Henriquess19/LIC_2021/Módulos/ModuloDoorController_G5.docx

O módulo Door Controller é constituído por 3 blocos, sendo dois desses hardware e um dos componentes software. A primeira componente baseia-se num controlador em software, a segunda é um controlador em hardware da porta e a última componente é a porta em questão.

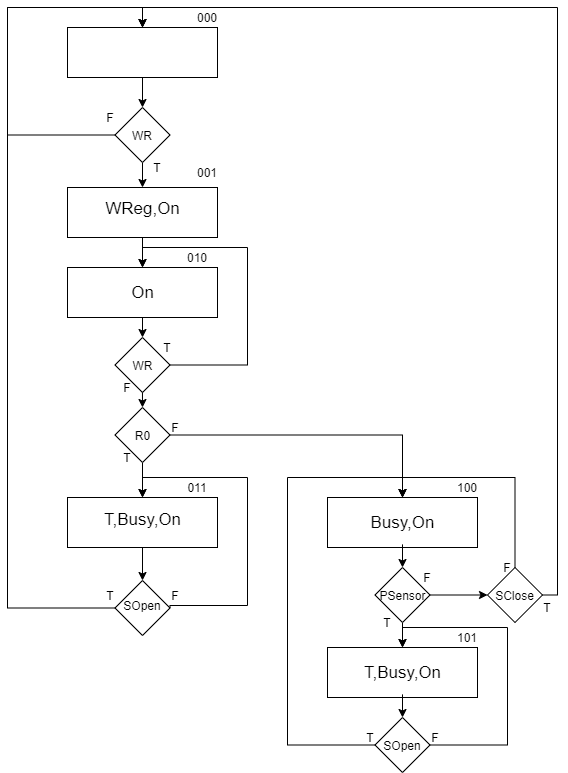
[picture p30: figure]

Figura 1 – Diagrama de blocos do módulo Door Controller

# 1 Controller

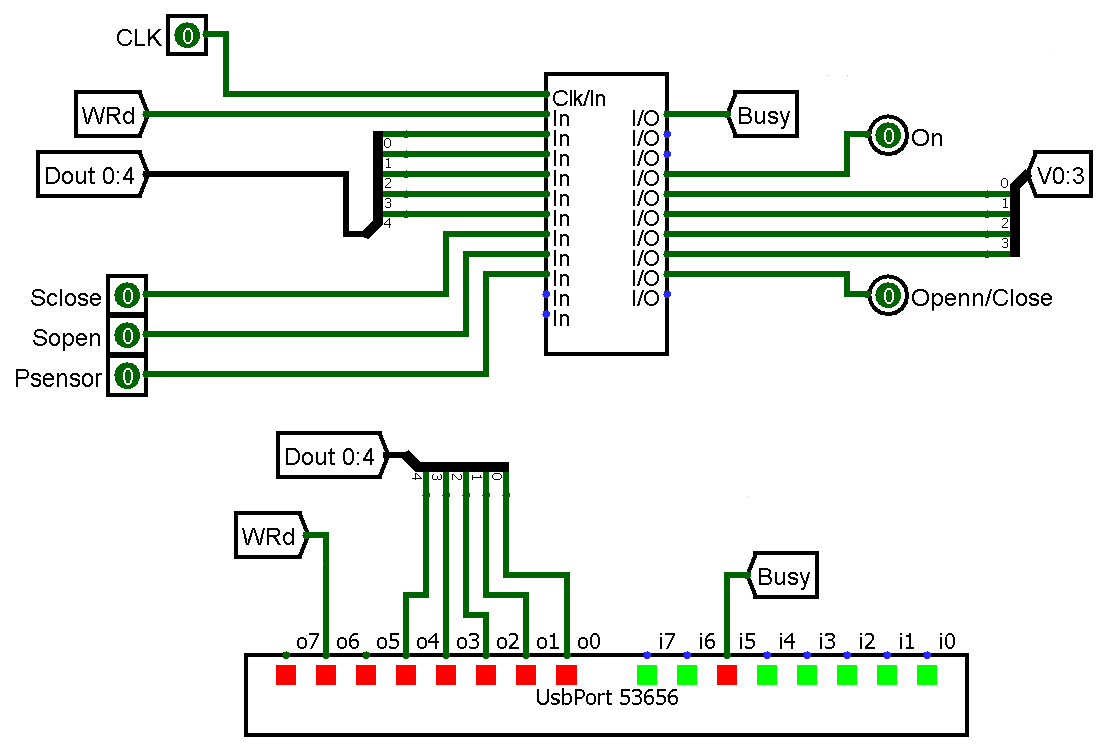
[picture p31: figure]

O bloco Controller implementa uma máquina de estados, que pode ser observada na figura 2 e a sua implementação em logisim e o seu ASM-chart na figura 3. É possível com esta implementação de hardware realizar uma ponte entre o software ao dispositivo da porta, tendo assim acesso e controlo do manuseamento da mesma. É possível enviar um simples comando e obter o processamento completo através de uma máquina de estados, e assim ter uma porta em funcionamento, com simples comando do hardware só. É demonstrada a implementação da pal com as conexões de entrada e saídas da mesma, na figura seguinte.

Figura 2 – Implementação Logisim do Controller

O bloco Controller foi implementado pela máquina de estados representada em ASM-chart na figura 3. Tendo como estado inicial o repouso, é permitida o avanço para estado seguinte conforme a indicação que existe uma leitura de dados a ser feita vinda do Control (WR), após passagem para o primeiro estado, onde se liga a máquina e colocação do valor do WReg a ‘1’ para registo dos valores de provenientes do Control. O estado seguinte serve para garantir que o sinal de clock do register se desloca para ‘0’ e que depois é verificado consoante o bit de maior peso da variável registada se era realizada a instrução de abertura ou fecho da porta, sendo a variável T a indicação que a operação é de abertura, no caso se for de abertura a porta só tem de se preocupar com o término da ação da mesma, se for de fecho tem de ter em preocupação adicional a verificação até à conclusão do seu fecho da existência da aparição de alguma pessoa, se tal deve de executar o método de abertura e depois pode realizar de novo o seu método de fecho ( pode ser observado no estado 4 e 5).

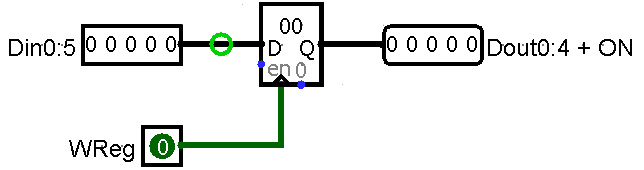
[picture p32: figure]

Figura 3– Máquina de estados do bloco Controller

Figura 4– Register da velocidade e acção da porta fornecidos pelo Control

A descrição hardware do bloco Controller em CUPL encontra-se no Anexo A.

Com base nas descrições do bloco Controller implementou-se parcialmente o módulo Door Controller de acordo com o esquema elétrico representado no Anexo B. Os clocks dados pela máquina são equivalentes ao clocks do modulo do Key Decode, 1KHz, permitindo assim que o projeto num todo trabalhe com união e todos poderem usufruir da mesma frequência de trabalho, excetuados os módulos que necessitam de uma menor por observações realizadas nos mesmos.

Em relação à latência de entrada no hardware, é muito baixa devido a ser providenciada por parte do software o que proporciona tempos de resposta mais pequenos, aquando comparados com os que são obtidos através dos mecanismos físicos. Em relação à latência de processamento e de saída da mesma, são valores maiores que os obtidos através do software, mas podem ser considerados "desprezáveis”, pois não afetam o funcionamento de um todo.

# 2 Interface com o Control

Implementou-se o módulo Control em software, recorrendo a linguagem Kotlin e seguindo a arquitetura lógica apresentada na Figura 5.

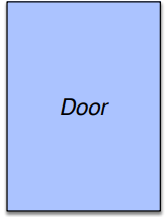
[picture p33: figure]
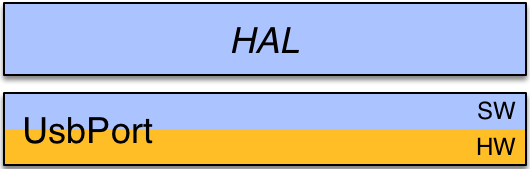
[picture p34: figure]

Figura 5 – Diagrama lógico do módulo Control de interface com o módulo Door Controller

A classe Door desenvolvida é descrita na secção 2.1., e o código fonte desenvolvido no Anexo C.

## 2.1 Classe Door

A classe Door foi implementada em 3 funções, excluindo a função de inicialização da mesma. A mesma, a função de inicialização baseia-se em colocar o WR a bit lógico ‘0’ para o sistema saber que se encontra no primeiro estado da máquina e assim só avançar do mesmo quando a chamada de alguma das funções quer de abertura ou de fecho.

Quer a função de abertura e de fecho, possuem um parâmetro que é a velocidade (speed), sendo a mesma que vai determinar a velocidade com que a porta executa a sua ação, esta devido a ser representada no máximo com 4 bits, o valor máximo que pode ser alcançado é de 15. O código em software não verifica a utilização da existência de pessoas ou se já se encontra aberta ou fechada, o único parâmetro a que tem acesso é o de ocupado (busy), o que permite o sistema saber se a ação foi concluída ou não.

Ambas as funções funcionam então de um método geral, semelhantes, verificando primeiro se a velocidade imposta não ultrapassa o máximo de 15. Depois caso a porta ainda esteja a processar um comando antigo, a função fica a espera que o bit de busy tenha o valor logico’0’, para executar o resto da função. Depois de ter a certeza que pode executar, escreve o valor da máscara de saída baseado na velocidade mais a indicação de se vai ser aberta ou fechada, que provêm da adição de 0x10, pois ao ser usado como o maior bit do inteiro que é aplicado ao HAL, permite que o mesmo não altere a velocidade desejada. Ambas as operações são concluídas quando há indicação que a porta já não se encontra mais ocupada; esta ação pode ser com a utilização da última função implementada onde a mesma indica se houve término conforme o valor do bit lógico de busy.

# 3 Conclusões

O módulo do Door Controller, é implementado com as suas duas vertentes necessárias para tal realização, a sua componente de software e a de hardware que permitem, em conjunto, que a porta consiga ter e realizar os devidos propósitos. Com a componente software é possível ter-se por parte de todo o sistema o conhecimento se a porta se encontra em uso ou não, o que acaba por ser prático e vantajoso; software também permite mudar a velocidade em questão o que ajuda a mudar conforme as situações que forem impostas e não só neste caso específico.

Tudo isto é possível por intermediário do bloco de hardware, que através da sua implementação com a atribuição da máquina de estados permite ao sistema gerir quer as informações transmitidas pelo software quer as informações que vão sendo transmitidas pela porta e realizar o melhor com as mesmas, quer abrir durante o fecho, em caso da presença de pessoa, quer nos casos mais simples e normais só de abertura e fecho sem interrupções da mesma.

# A. Descrição CUPL do bloco Controller


# B. Esquema elétrico do módulo Door Controller


# C. Código Kotlin da classe Door

object Door{
private const val WR_MASK = 0x40
private const val BUSY_MASK = 0x20
private const val D_OUT_MASK = 0x1F
private const val MAX_SPEED = 0x0F

private const val OPEN_CMD = 0x10
private const val CLOSE_CMD = 0x00

fun init(){
HAL.clrBits(WR_MASK)
}

/**
* V0~3 -> 0x0F
*
* OpenClose -> OPEN = 0x10 & CLOSE = 0x00
*/

fun open(speed:Int){
var spd = speed
if (spd > MAX_SPEED) spd = MAX_SPEED
val x = OPEN_CMD + spd /*Open action + speed*/
while (HAL.isBit(BUSY_MASK)){} /*Waiting for the busy signal*/
HAL.writeBits(D_OUT_MASK, x)
HAL.setBits(WR_MASK)
HAL.clrBits(WR_MASK)

}

fun close(speed: Int){
var spd=speed
if (spd > MAX_SPEED) spd=MAX_SPEED
val x = CLOSE_CMD + spd /*Close action + speed*/
while (HAL.isBit(BUSY_MASK)){} /*Waiting for the busy signal*/
HAL.writeBits(D_OUT_MASK,x)
HAL.setBits(WR_MASK)
HAL.clrBits(WR_MASK)
}


fun isFinished():Boolean{
return !HAL.isBit(BUSY_MASK)
}
}

fun main(){

Door.init()

while (true) {

val x = (-100..100).random() /* TestCode to give random number so door open or close with the value of x*/

println(x)

if (x <= 0) {

Door.close(12)

} else {

Door.open(12)

}

while (!Door.isFinished()){}

}

}

Door Controller (Working Time Recorder) Laboratório de Informática e Computadores 2020 / 2021 verão Autores: Ricardo Henriques (A48322@alunos.isel.pt) João Magalhães (A48348@alunos.isel.pt)
