Henriquess19/LIC_2021/Hardware/DoorController/DOOR_ASM.png

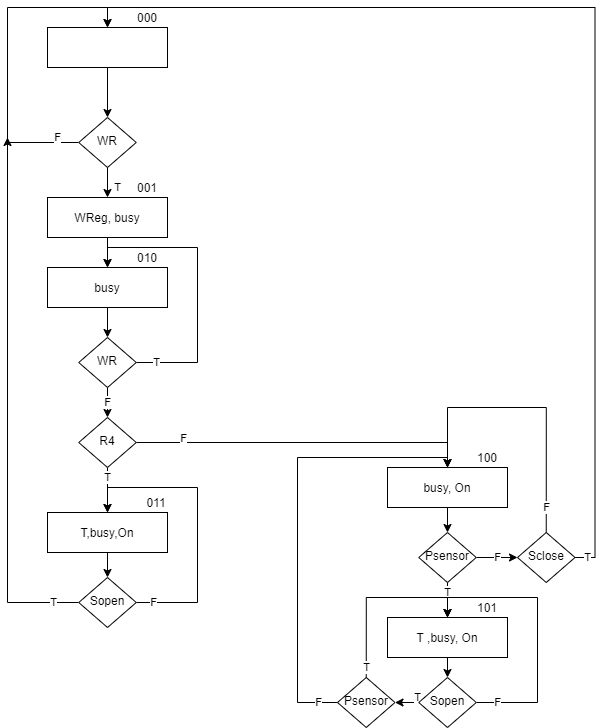
Hardware/DoorController/DOOR_ASM.png
