Henriquess19/LIC_2021/Hardware/KeyboardReader/KeyboardReader_ASM.png

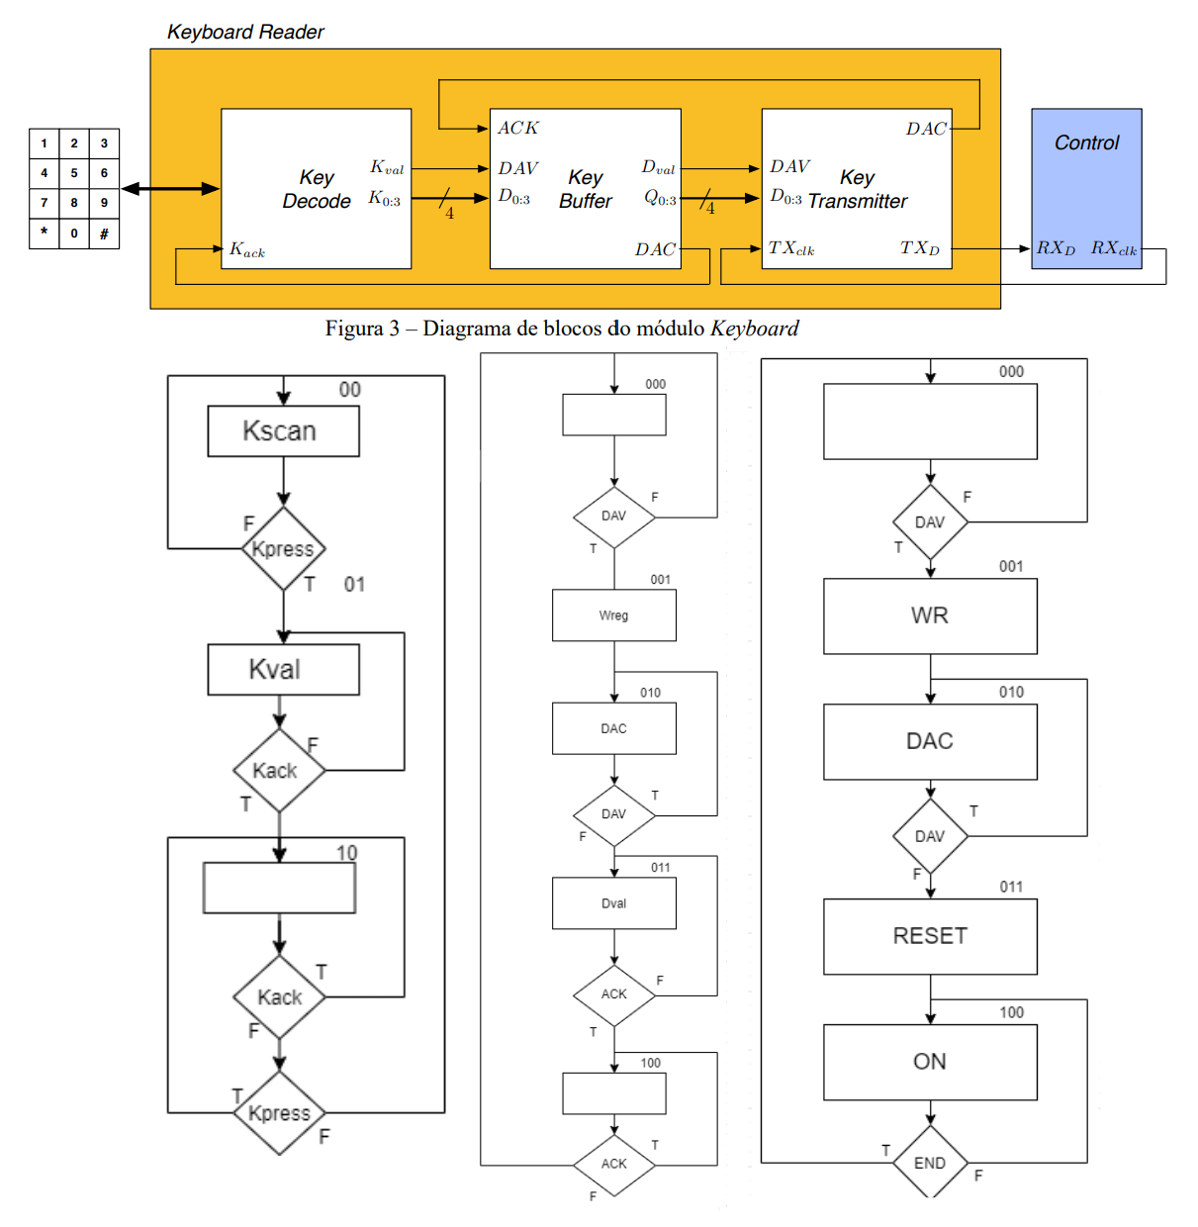
Hardware/KeyboardReader/KeyboardReader_ASM.png
