Henriquess19/LIC_2021/(list of files, drawings)

Other design files:
Hardware/DoorController/DoorController.circ
Hardware/KeyboardReader/KeyboardReader.circ
Hardware/KeyboardReader/KeyboardTransmitter.circ
Hardware/LCD/LCD.circ
Hardware/Orcad/Orcad_ModuloKey/WORKING_TIME_RECORDER.DSN
Hardware/Orcad/Orcad_ModuloKey/Working_Time_Recorder.opj
